shimniok/LPC210x-breakout/documentation/Pinout.png

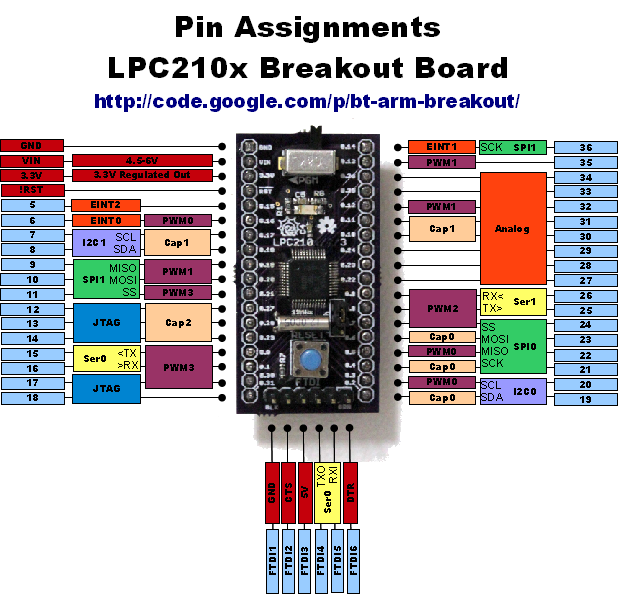
documentation/Pinout.png
