shimniok/LPC210x-breakout/documentation/Pinout.pdf

# Pin Assignments

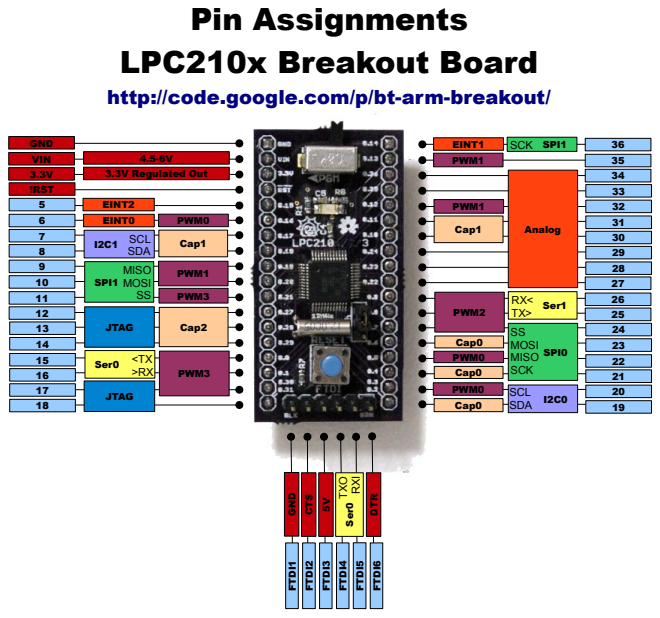
[picture p2: page 1]
VIN; GND; 3.3V !RST 5 6 7 8 9; 4.5-6V 3.3V Regulated Out; EINT2 EINT0; Analog; Ser1; SPI0; SPI1; Ser0; JTAG; PWM3; Cap2; PWM1; SCL SDA; SS MOSI MISO SCK; PWM2; MISO MOSI SS; Cap1; Cap0; Cap0 PWM0; PWM0; EINT1; SCK; Ser0 <TX >RX

LPC210x Breakout Board
http://code.google.com/p/bt-arm-breakout/
