shimniok/LPC210x-breakout/electronics/LPC2101 Breakout_brd_bot.pdf

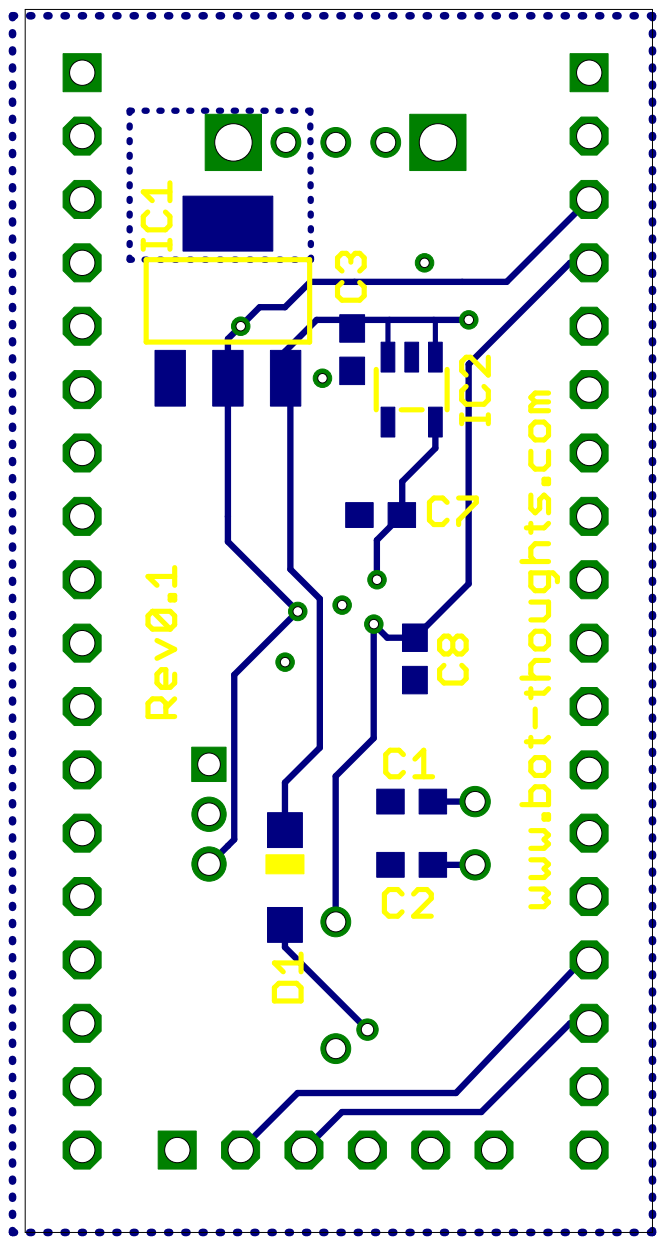
[picture p3: page 1]
