shimniok/LPC210x-breakout/electronics/LPC2101 Breakout_brd_top.pdf

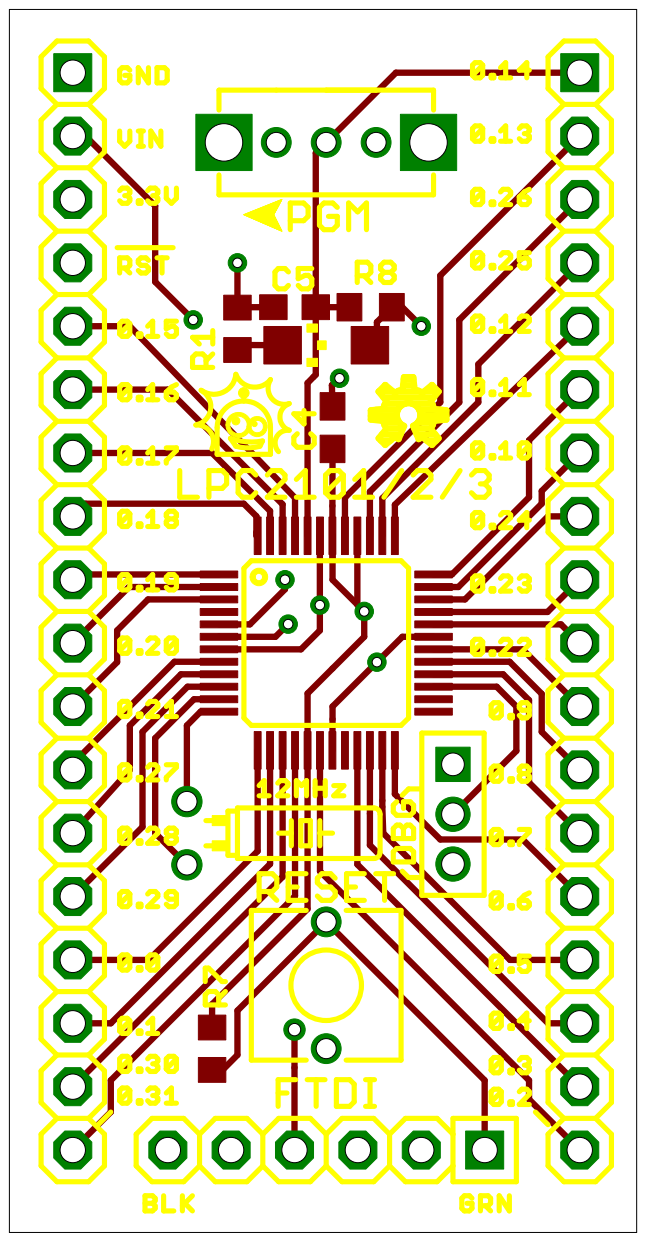
[picture p4: page 1]
