shimniok/LPC210x-breakout/electronics/LPC2101 Breakout_sch.pdf

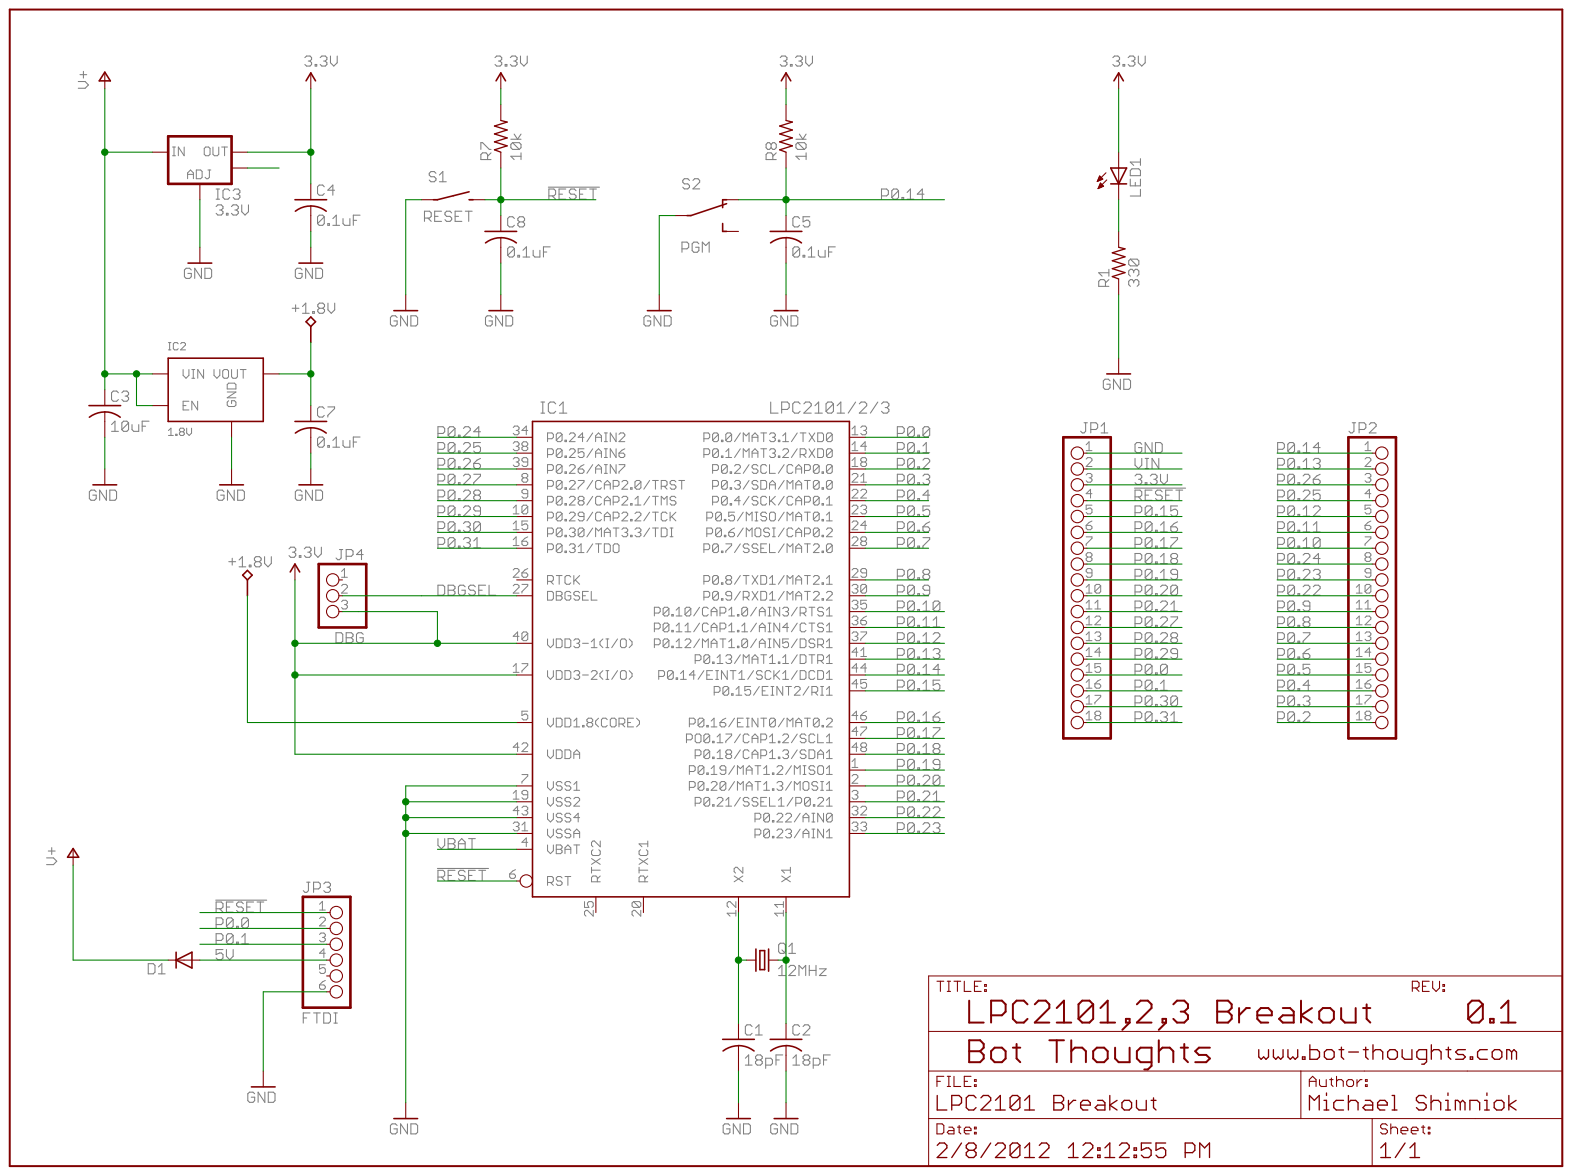
[picture p5: page 1]
