shimniok/LPC210x-breakout/electronics/LPC2101 Breakout.brd

## EAGLE design electronics/LPC2101 Breakout.brd (2012-02-23)

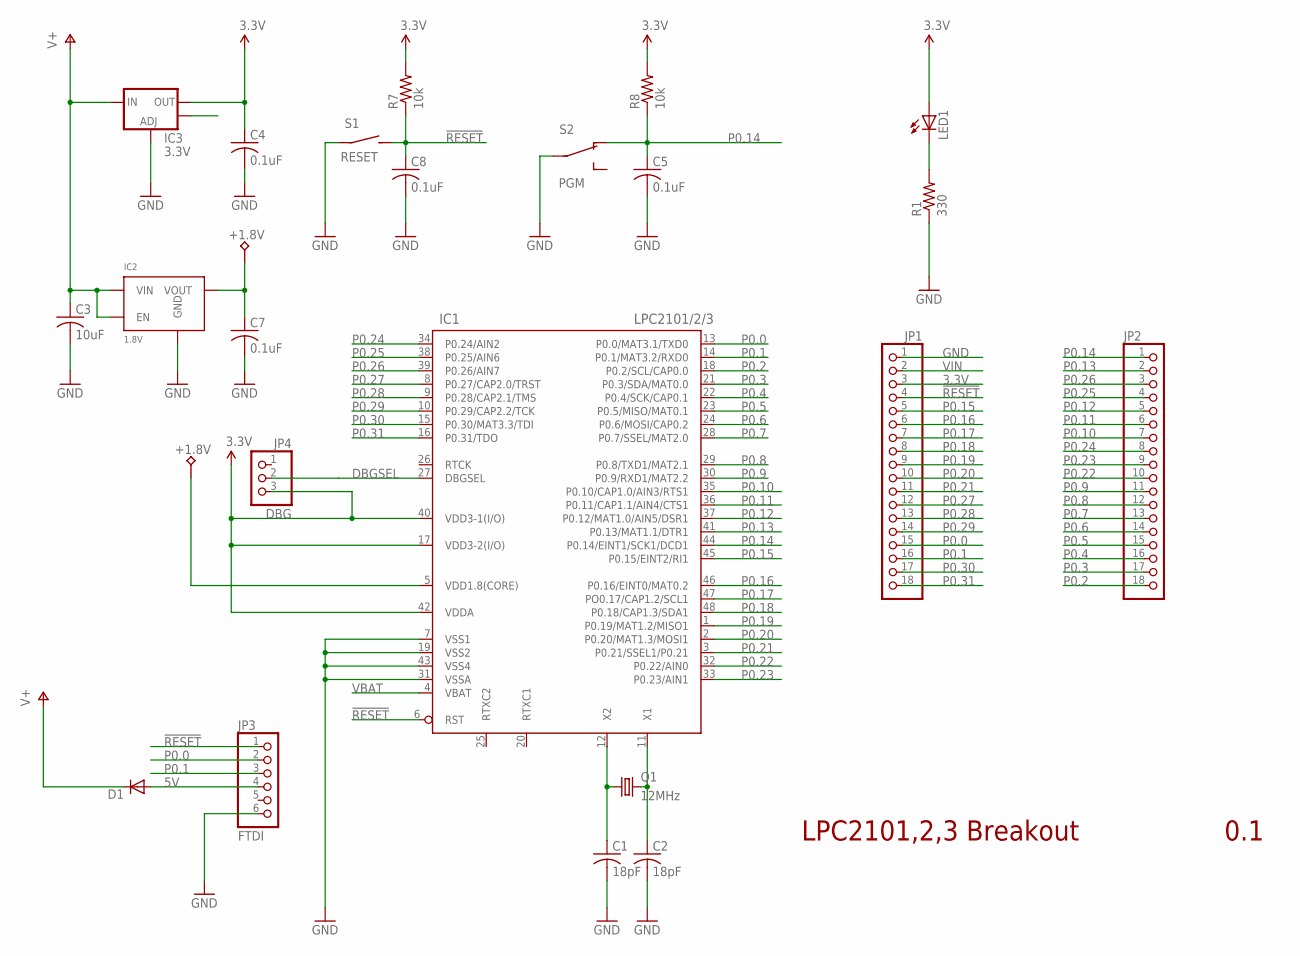
[picture p6: schematic LPC2101 Breakout.sch]

Parts:
C1, C2: 18pF; C0603; PARTNO C1608C0G1H180J
C3: 10uF; C0603; PARTNO C1608X5R0J106M_DK
C4, C5, C7, C8: 0.1uF; C0603; PARTNO CX0603MRX7R6BB104
D1: DIODE-SOD123; SOD123; PARTNO CGRM4001-G
IC1: LPC2101/2/3; LQFP48; PARTNO LPC2101FBD48,151
IC2: 1.8V; SOT23-5; PARTNO TLV70018DDCT
IC3: 3.3V; SOT223; PARTNO SALVAGE
JP1, JP2: PINHD-1X18_2.54-S; 1X18-S
JP3: FTDI; 1X06-S
JP4: DBG; 1X03M; PARTNO 951103-8622-AR
LED1: LEDCHIPLED_1206; CHIPLED_1206; PARTNO LG N971-KN-1
Q1: 12MHz; TC26H; PARTNO CSA309-12.000MABJ-UB
R1: 330; R0603; PARTNO ERJ-3GEYJ331V
R7, R8: 10k; R0603; PARTNO ERJ-3GEYJ103V
S1: RESET; 6MMTACTILE; PARTNO SALVAGE
S2: PGM; OS102011MA1Q; PARTNO OS102011MA1QS1

Connections:
3.3V: C4.1, IC1.17 (VDD3-2(I/O)), IC1.40 (VDD3-1(I/O)), IC1.42 (VDDA), IC3.2 (OUT), JP1.3, JP4.3, LED1.A, R7.2, R8.2
5V: D1.A, JP3.4
!RESET: C8.1, IC1.6 (RST), JP1.4, JP3.1, R7.1, S1.P$2 (S)
+1.8V: C7.1, IC1.5 (VDD1.8(CORE)), IC2.5 (VOUT)
DBGSEL: IC1.27 (DBGSEL), JP4.2
GND: C1.2, C2.2, C3.2, C4.2, C5.2, C7.2, C8.2, IC1.7 (VSS1), IC1.19 (VSS2), IC1.31 (VSSA), IC1.43 (VSS4), IC2.2 (GND), IC3.1 (ADJ), JP1.1, JP3.6, R1.1, S1.P$1, S2.P$2
HS1: IC3.4 (OUT)
unnamed: LED1.C, R1.2
unnamed: C2.1, IC1.11 (X1), Q1.2
unnamed: C1.1, IC1.12 (X2), Q1.1
P0.0: IC1.13 (P0.0/MAT3.1/TXD0), JP1.15, JP3.2
P0.1: IC1.14 (P0.1/MAT3.2/RXD0), JP1.16, JP3.3
P0.2: IC1.18 (P0.2/SCL/CAP0.0), JP2.18
P0.3: IC1.21 (P0.3/SDA/MAT0.0), JP2.17
P0.4: IC1.22 (P0.4/SCK/CAP0.1), JP2.16
P0.5: IC1.23 (P0.5/MISO/MAT0.1), JP2.15
P0.6: IC1.24 (P0.6/MOSI/CAP0.2), JP2.14
P0.7: IC1.28 (P0.7/SSEL/MAT2.0), JP2.13
P0.8: IC1.29 (P0.8/TXD1/MAT2.1), JP2.12
P0.9: IC1.30 (P0.9/RXD1/MAT2.2), JP2.11
P0.10: IC1.35 (P0.10/CAP1.0/AIN3/RTS1), JP2.7
P0.11: IC1.36 (P0.11/CAP1.1/AIN4/CTS1), JP2.6
P0.12: IC1.37 (P0.12/MAT1.0/AIN5/DSR1), JP2.5
P0.13: IC1.41 (P0.13/MAT1.1/DTR1), JP2.2
P0.14: C5.1, IC1.44 (P0.14/EINT1/SCK1/DCD1), JP2.1, R8.1, S2.P$1 (O1)
P0.15: IC1.45 (P0.15/EINT2/RI1), JP1.5
P0.16: IC1.46 (P0.16/EINT0/MAT0.2), JP1.6
P0.17: IC1.47 (PO0.17/CAP1.2/SCL1), JP1.7
P0.18: IC1.48 (P0.18/CAP1.3/SDA1), JP1.8
P0.19: IC1.1 (P0.19/MAT1.2/MISO1), JP1.9
P0.20: IC1.2 (P0.20/MAT1.3/MOSI1), JP1.10
P0.21: IC1.3 (P0.21/SSEL1/P0.21), JP1.11
P0.22: IC1.32 (P0.22/AIN0), JP2.10
P0.23: IC1.33 (P0.23/AIN1), JP2.9
P0.24: IC1.34 (P0.24/AIN2), JP2.8
P0.25: IC1.38 (P0.25/AIN6), JP2.4
P0.26: IC1.39 (P0.26/AIN7), JP2.3
P0.27: IC1.8 (P0.27/CAP2.0/TRST), JP1.12
P0.28: IC1.9 (P0.28/CAP2.1/TMS), JP1.13
P0.29: IC1.10 (P0.29/CAP2.2/TCK), JP1.14
P0.30: IC1.15 (P0.30/MAT3.3/TDI), JP1.17
P0.31: IC1.16 (P0.31/TDO), JP1.18
VBAT: IC1.4 (VBAT)
VIN: C3.1, D1.C, IC2.1 (VIN), IC2.3 (EN), IC3.3 (IN), JP1.2

Notes on the sheet:
LPC2101,2,3 Breakout
0.1

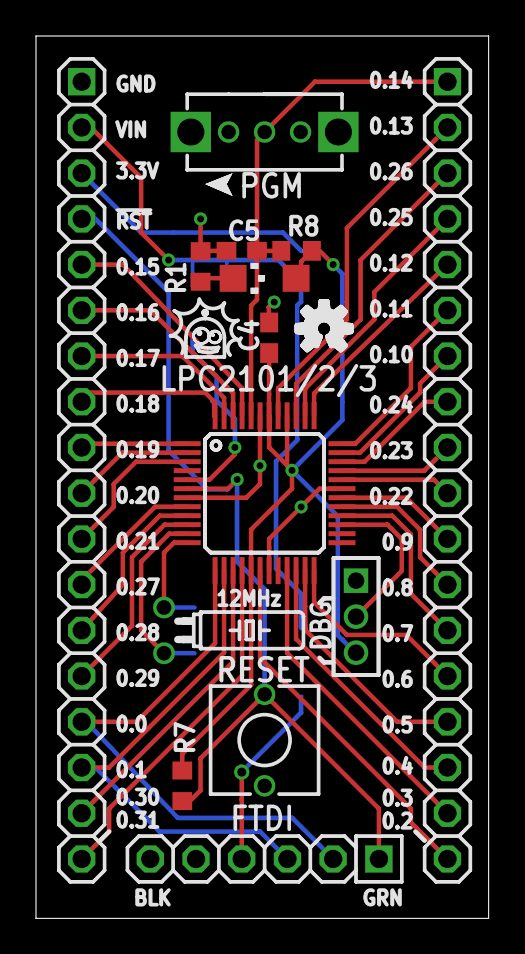
[picture p7: board LPC2101 Breakout.brd from above]

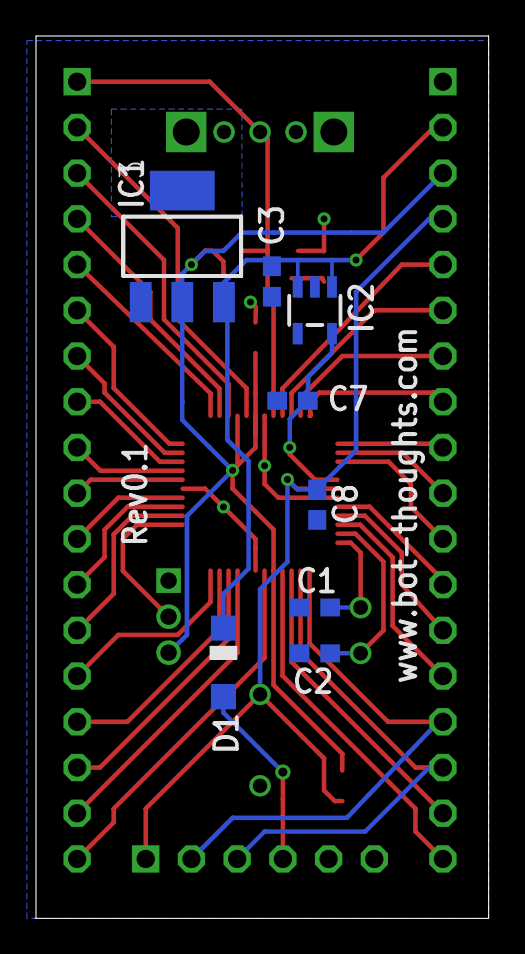
[picture p8: board LPC2101 Breakout.brd from below]

Board: 2 copper layers, 25.1 x 49.0 mm, 22 parts (8 on the bottom side), 42 nets.
