shimniok/LPC210x-breakout/(commit log)

2012-02-23 Initial Revision 0.1
    [LPC2101 Breakout.brd, LPC2101 Breakout.sch, LPC2101 Breakout_DigiKeyOrder.csv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]
2012-02-23 Moving to folder
    [LPC2101 Breakout.brd]
2012-02-27 Put readme material in main.c
2012-04-03 Initial revision of timer/interrupt-based LED blink
2015-08-07 Moved all files into top level directory
    [LPC2101 Breakout.brd, LPC2101 Breakout.sch, LPC2101 Breakout_DigiKeyOrder.csv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]
2015-08-07 Moved electronics to subdir, moved documentation to subdir
    [LPC2101 Breakout.brd, LPC2101 Breakout.sch, LPC2101 Breakout_DigiKeyOrder.csv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]
